azzajess/USB-Shifter-to-Thrustmaster-Wheelbase/Images/Shifter Wiring Diagram.jpg

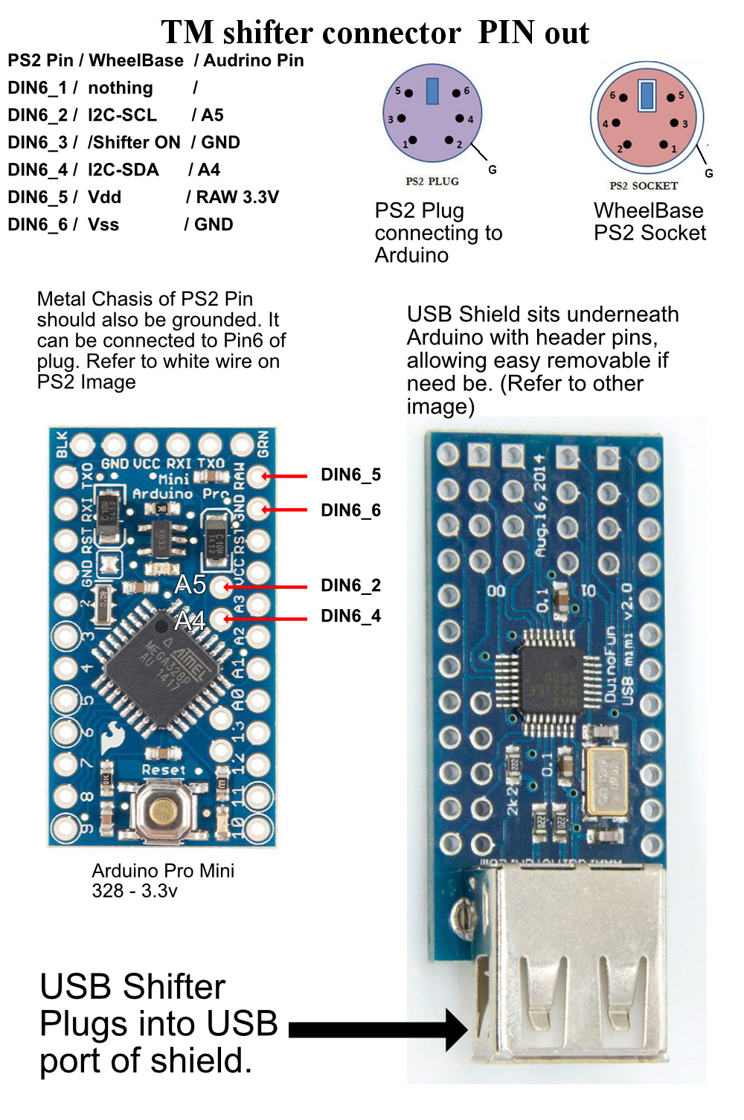
Images/Shifter Wiring Diagram.jpg
