azzajess/USB-Shifter-to-Thrustmaster-Wheelbase/Images/Hardwire Shifter Wiring Diagram.jpg

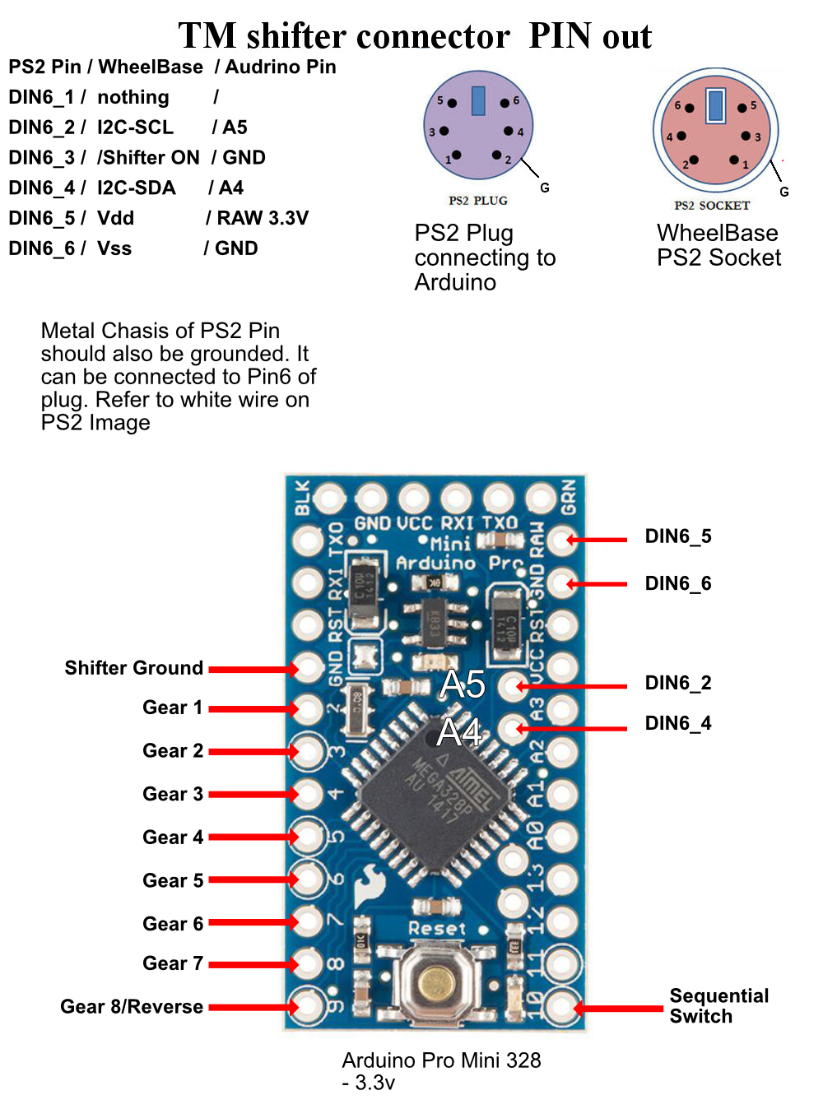
Images/Hardwire Shifter Wiring Diagram.jpg
