azzajess/USB-Shifter-to-Thrustmaster-Wheelbase/Images/Close up of PCB with pins.JPG

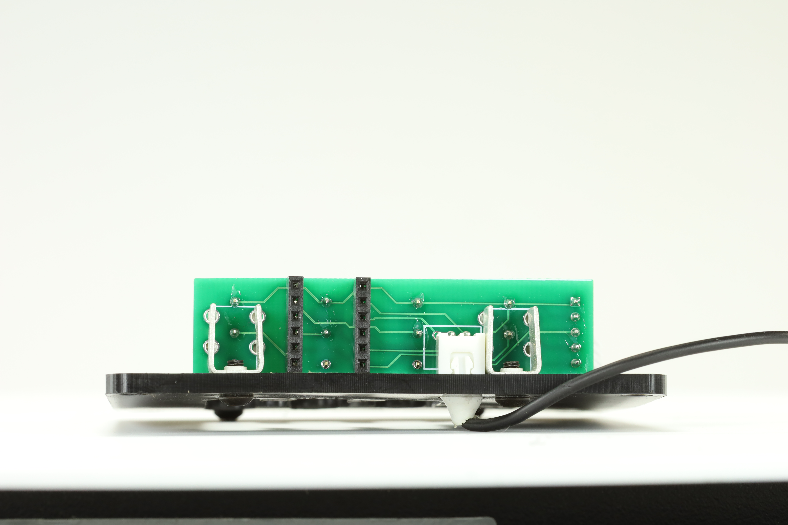
Images/Close up of PCB with pins.JPG
