azzajess/USB-Shifter-to-Thrustmaster-Wheelbase/Images/IMG_20230221_194732.jpg

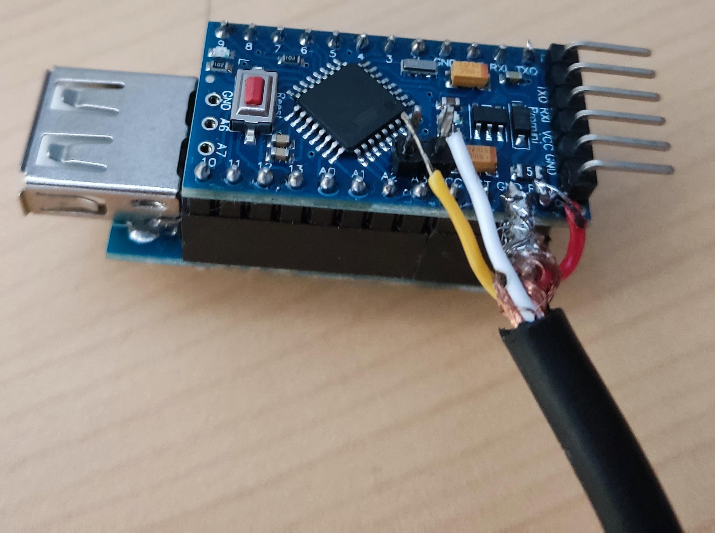
Images/IMG_20230221_194732.jpg
