azzajess/USB-Shifter-to-Thrustmaster-Wheelbase/Images/IMG_20230221_194917.jpg

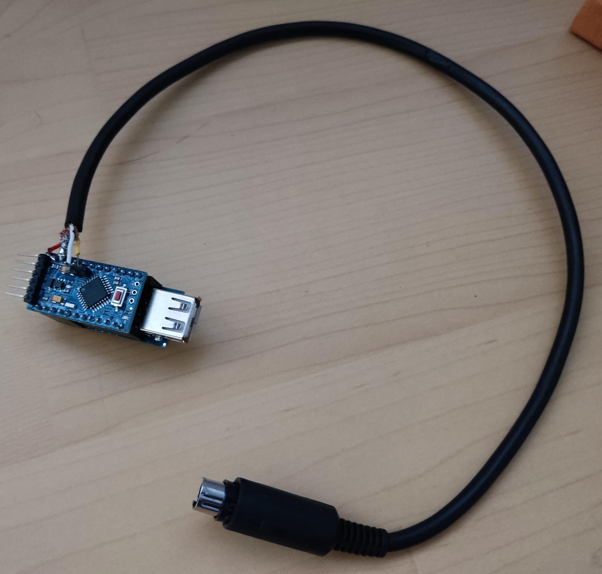
Images/IMG_20230221_194917.jpg
