azzajess/USB-Shifter-to-Thrustmaster-Wheelbase/Images/Pinout of Shifter PCB 6+R+switch Ver.jpg

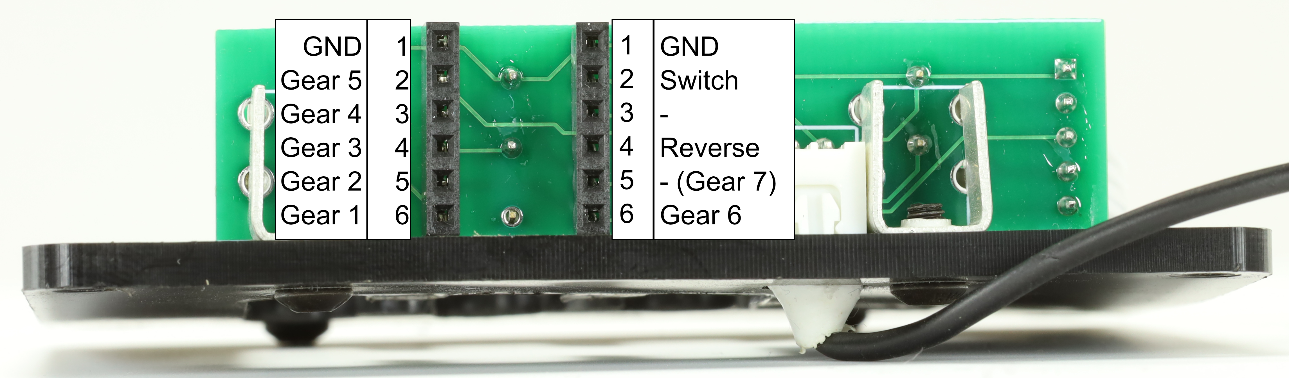
Images/Pinout of Shifter PCB 6+R+switch Ver.jpg
