azzajess/USB-Shifter-to-Thrustmaster-Wheelbase/Images/USB Shifter.jpg

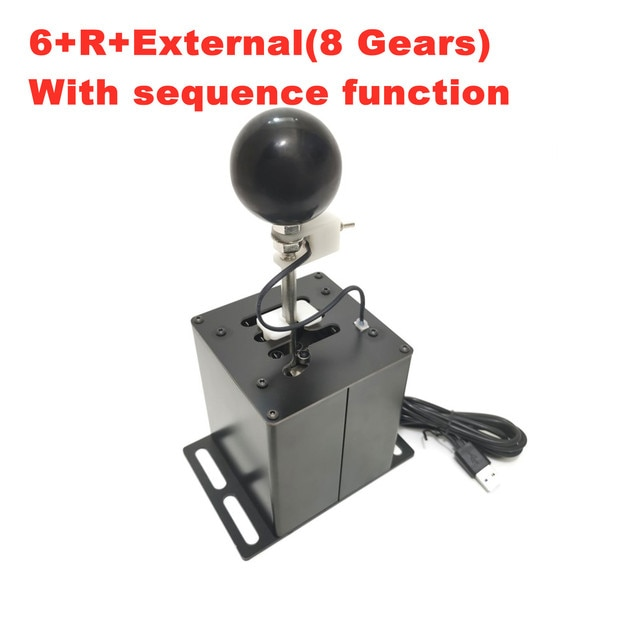
Images/USB Shifter.jpg
