azzajess/USB-Shifter-to-Thrustmaster-Wheelbase/ISRTV.com Resources/PS2 Port Wiring Image (from ISRTV by VSteve).jpg

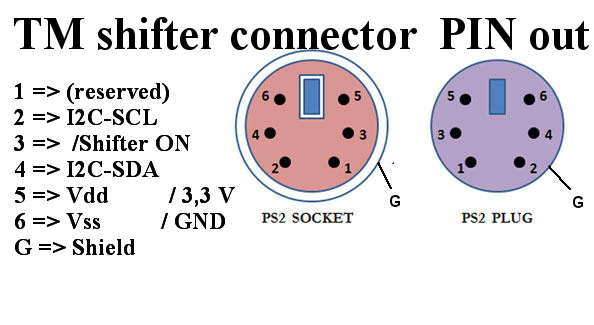
ISRTV.com Resources/PS2 Port Wiring Image (from ISRTV by VSteve).jpg
