azzajess/USB-Shifter-to-Thrustmaster-Wheelbase/ISRTV.com Resources/PS3 Port Wiring Example (from ISRTV by MakeyneGT).jpg

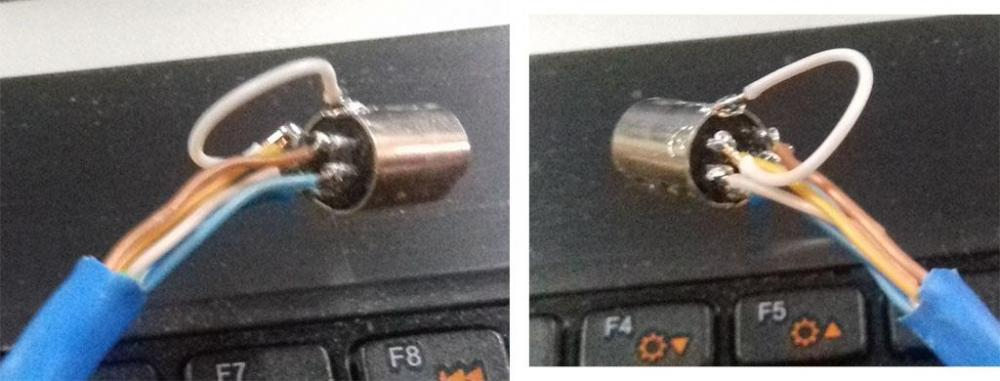
ISRTV.com Resources/PS3 Port Wiring Example (from ISRTV by MakeyneGT).jpg
