azzajess/USB-Shifter-to-Thrustmaster-Wheelbase/Images/Shifter Debugging.PNG

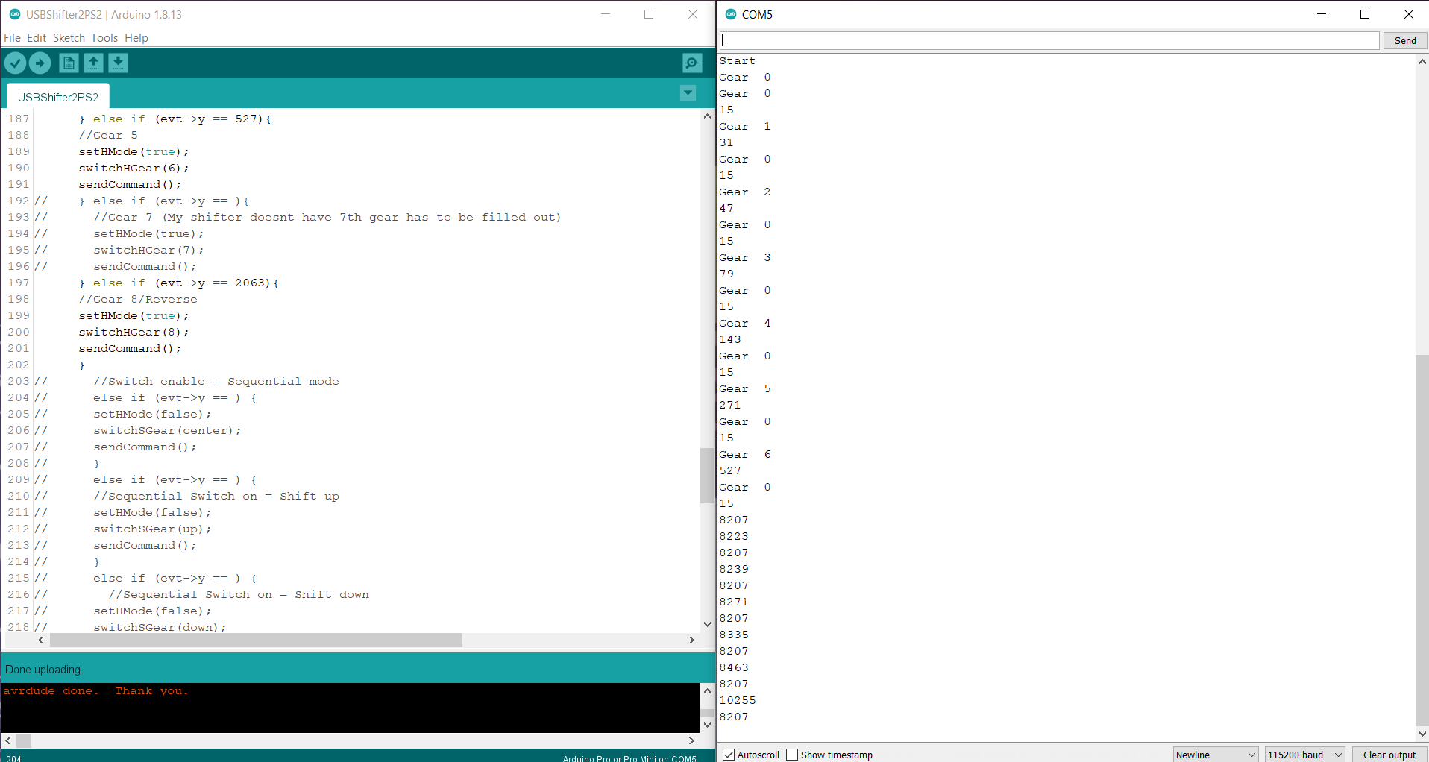
Images/Shifter Debugging.PNG
