azzajess/USB-Shifter-to-Thrustmaster-Wheelbase/(threads)

Thread 2 (2023-06-25):

Different shifter model need advice :)

azzajess, 2023-06-25:
### Discussed in https://github.com/azzajess/USB-Shifter-to-Thrustmaster-Wheelbase/discussions/1

<div type='discussions-op-text'>

<sup>Originally posted by **NikderNoob95** June 25, 2023</sup>
Hi, what a cool idea. I've bought an alibaba shifter 6+R similar like yours and want to connect it to a T300RS wheel to get it to work
with Gran Turismo 7 on PS5.
So I found your page and soldered everything like you described, the hardware part is working now I think.
But after studying the code I found out, that my shifter looks exactly the same, but has a switch for each gear instead of
a Joystick/axis.
Do you have an idea how I can get it to detect the button inputs to shift the gears? I have no changing signal in the serial plotter now...
Thank you</div>

Closed 2023-06-30.

Thread 14 (2024-07-12):

Add RPI Pico Method

azzajess, 2024-07-12:
Will have to investigate to see if its viable/possible to use a pico instead of arduino. Just have to note the 3v requirement.

Thread 15 (2024-07-23):

Hall Effect USB Shifter Support

azzajess, 2024-07-23:
Add code support for USB Shifter that uses hall effect sensors of sorts rather than switches.

Thread 16 (2024-07-23):

Add Support for Type C internal Board USB Shifters

azzajess, 2024-07-23:
There are USB Shifters that have a type C internal control board. I currently dont have codes/wiring to support these boards yet since I dont have a shifter that does this.

If someone has one of these boards, and have the codes, ill love to know

Thread 17 (2025-01-27):

My plug doesn't have the same pinout as it should

Switchproyt, 2025-01-27:

azzajess, 2025-01-27:
Its become apparent that there are a bunch of different versions out there that all look the same externally but decide to change the internals.

If yours is different then maybe we can get pictures and try and figure it out from there? Or if you do, please share if you can

Switchproyt, 2025-01-31:
yeah sounds good one min

Switchproyt, 2025-01-31:
im using one from an old keyboard i tried it with an old mouse too should i buy a male to female one?

azzajess, 2025-01-31:
You can try to use a multi meter on Continuity mode to check and make sure all the wires are present and connected to their own pin.
In some cases the PS2 mice and keyboard don't have the necessary sites to make the connection as they are unnecessary. So make sure you have essentially 6 wires in the PS2 cable all connected to their own PIN.
It might be easier to get a cable male to female as hopefully that has all the wires in it, but check your current wires first

Switchproyt, 2025-01-31:
So this is my cable setup

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

azzajess, 2025-01-31:
I don't think that'd gonna work due to orange being on the wrong side. If you line up the cable to the wheel, you can see the orange pin lines up with pin 1 according to diagram which does nothing.
That might be it?

Switchproyt, 2025-01-31:
So just buy a new one ?

azzajess, 2025-01-31:
Ideally you should
