azzajess/USB-Shifter-to-Thrustmaster-Wheelbase/(commit log)

2022-10-02 ISRTV resources
    https://www.isrtv.com/forums/topic/24532-gearbox-connector-on-base/
2023-02-21 Added Quick Wiring Guide
2023-02-21 Added Pictures of board and Wiring Diagram
2023-07-11 Testing Ino file for direct wire shifting
2023-07-12 Update HardwireShifterTest.ino
    removed some serial prints for gears, reducing double ups
2023-07-21 Hardwire shifter arduino file
    Made up a Arduino code for hardwiring USB shifter to Arduino.
2023-08-06 Update README.md
    added top plate info
2023-08-06 Update ShifterDirectWire.md
    added pin text
2023-08-06 Update USBShield.md
    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
2024-04-13 Update ShifterDirectWire.md
    Added note about Grounding metal chasis
2024-04-13 Update USBShield.md
    Updated note about grounding PS2 metal chasis
